todbot/picotouch_pad/README.md

# picotouch_pad
picotouch MIDI controller, but pad-based
