todbot/picotouch_pad/schematics/picotouch_pad/picotouch_pad.kicad_pcb

## KiCad design schematics/picotouch_pad/picotouch_pad.kicad_pcb (2024-12-15)

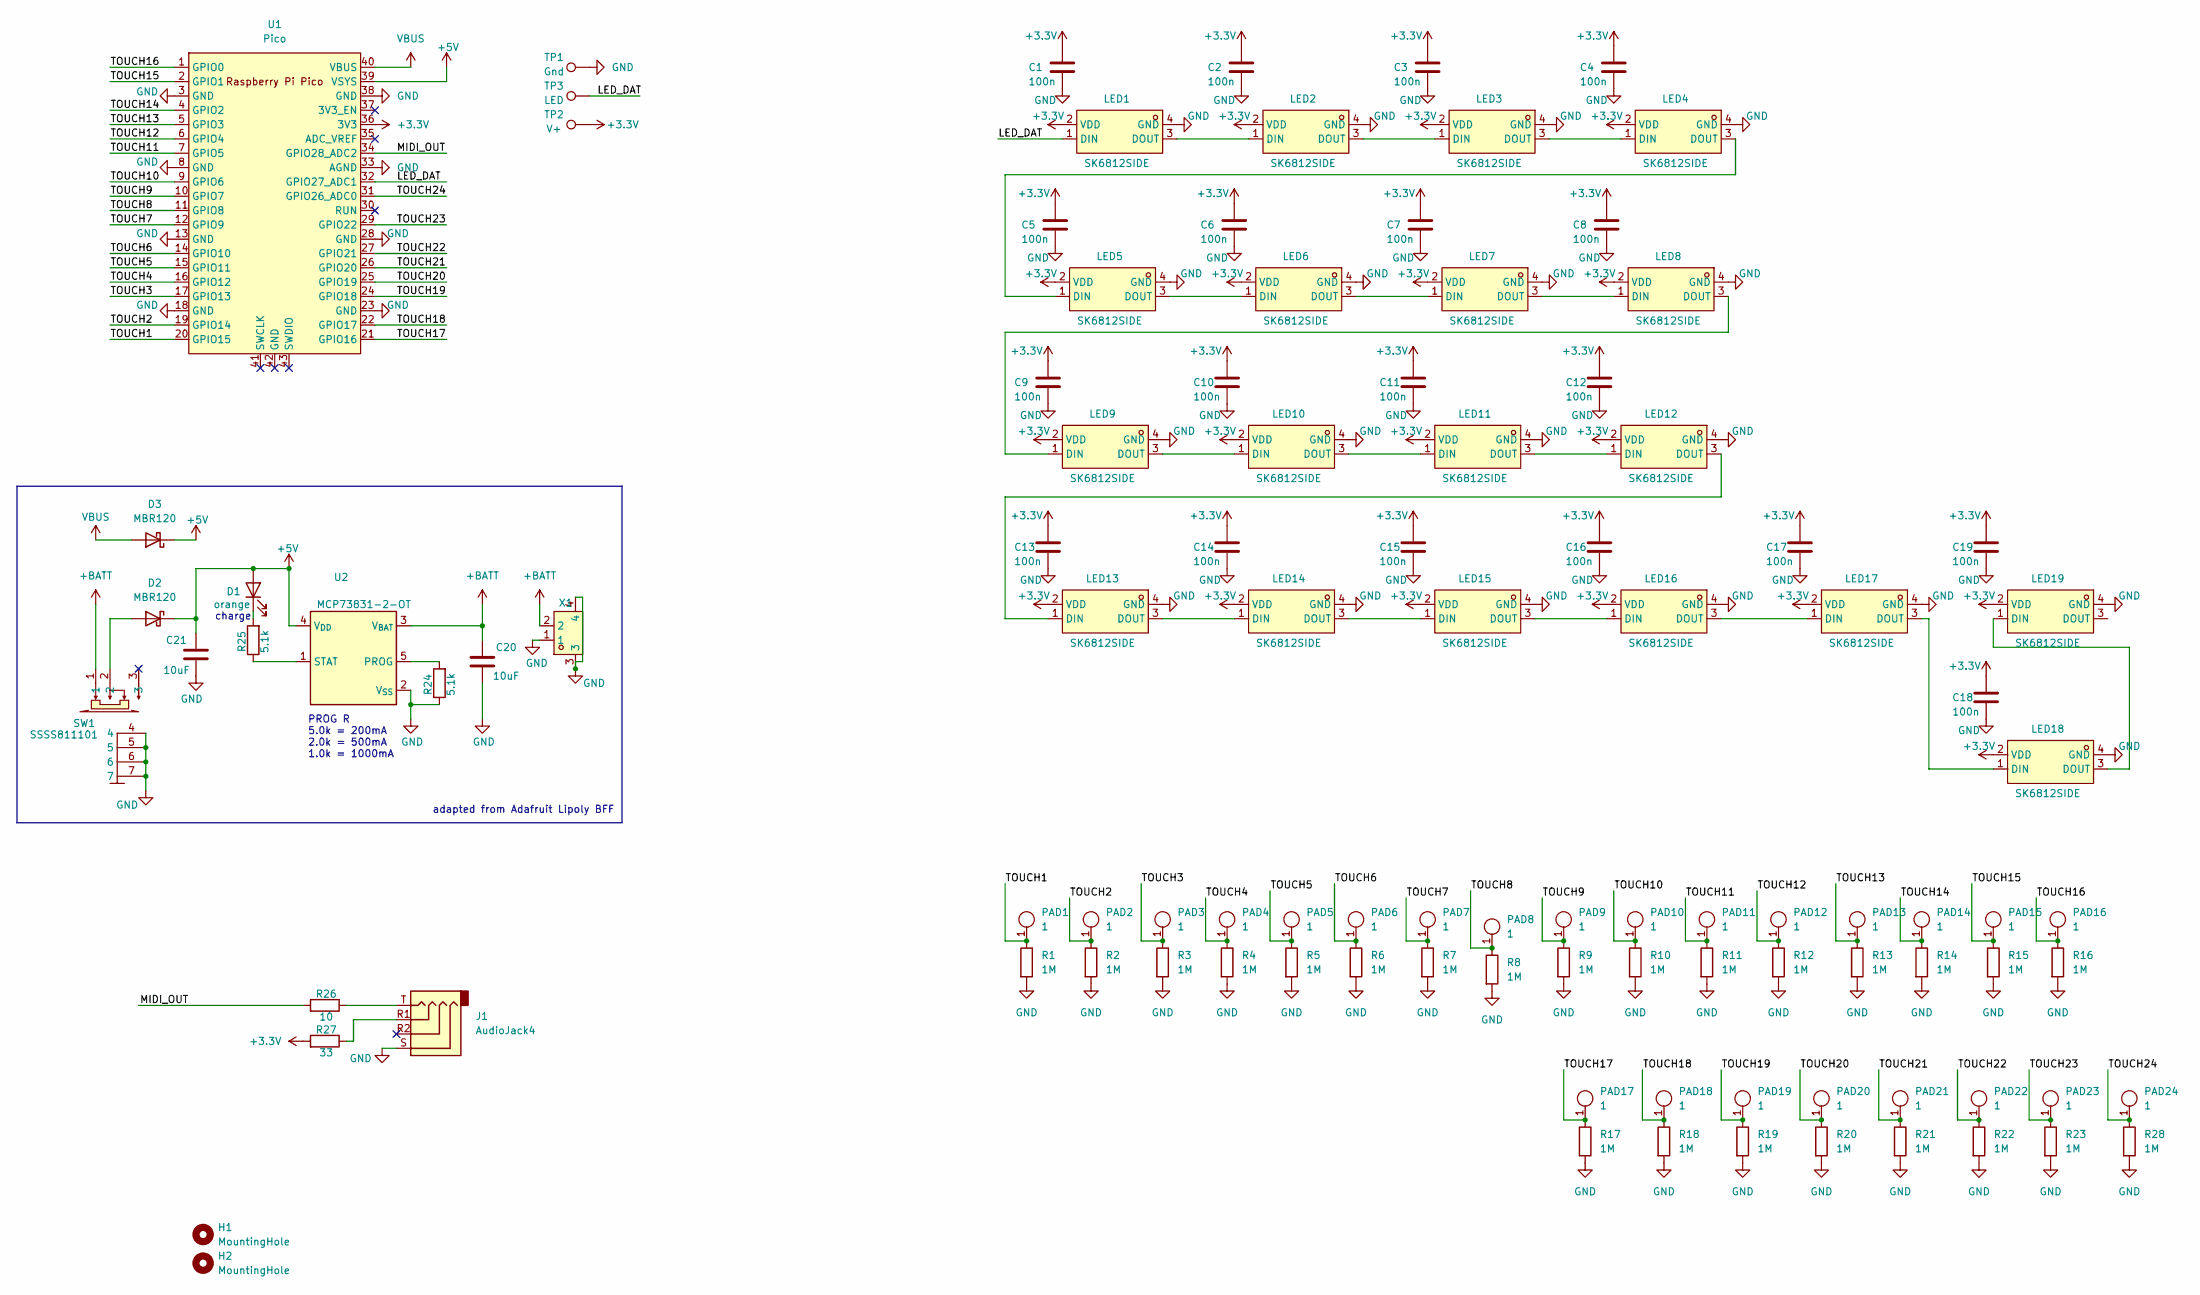
[picture p1: schematic picotouch_pad.kicad_sch]

Parts:
C1, C2, C3, C4, C5, C6, C7, C8, C9, C10, C11, C12, C13, C14, C15, C16, C17, C18, C19: 100n; C_0603_1608Metric
C20, C21: 10uF; C_0603_1608Metric
D1: orange; LED_0603_1608Metric
D2, D3: MBR120; D_SOD-123F; LCSC Part C130880
H1, H2: MountingHole; MountingHole_2.7mm_M2.5
J1: AudioJack4; Jack_3.5mm_PJ320D_Horizontal; LCSC C431535
LED1, LED2, LED3, LED4, LED5, LED6, LED7, LED8, LED9, LED10, LED11, LED12, LED13, LED14, LED15, LED16, LED17, LED18, LED19: SK6812SIDE; LED-SMD_4P-L4.0-W1.6-L-keepoutrev; LCSC Part C5378721
PAD1, PAD2, PAD3, PAD4, PAD5, PAD6, PAD7, PAD8, PAD9, PAD10, PAD11, PAD12, PAD13, PAD14, PAD15, PAD16: 1; Pad-CapTouch-10mm-roundrect
PAD17, PAD18, PAD19, PAD20, PAD21, PAD22, PAD23, PAD24: 1; Pad-CapTouch-10x5mm-roundrect
R1, R2, R3, R4, R5, R6, R7, R8, R9, R10, R11, R12, R13, R14, R15, R16, R17, R18, R19, R20, R21, R22, R23, R28: 1M; R_0603_1608Metric
R24, R25: 5.1k; R_0603_1608Metric
R26: 10; R_0603_1608Metric
R27: 33; R_0603_1608Metric
SW1: SSSS811101; SW-SMD_SSSS811101; LCSC Part C109335
TP1: Gnd; TestPoint_Pad_D1.5mm
TP2: V+; TestPoint_Pad_D1.5mm
TP3: LED; TestPoint_Pad_D1.5mm
U1: Pico; RPi_Pico_SMD
U2: MCP73831-2-OT; SOT-23-5; LCSC Part C424093
X1: AFC20-S02ACA-00; CONN-SMD_AFC20-S02ACA-00; LCSC Part C2764211

Connections:
+3.3V: C1.1, C2.1, C3.1, C4.1, C5.1, C6.1, C7.1, C8.1, C9.1, C10.1, C11.1, C12.1, C13.1, C14.1, C15.1, C16.1, C17.1, C18.1, C19.1, LED1.2 (VDD), LED2.2 (VDD), LED3.2 (VDD), LED4.2 (VDD), LED5.2 (VDD), LED6.2 (VDD), LED7.2 (VDD), LED8.2 (VDD), LED9.2 (VDD), LED10.2 (VDD), LED11.2 (VDD), LED12.2 (VDD), LED13.2 (VDD), LED14.2 (VDD), LED15.2 (VDD), LED16.2 (VDD), LED17.2 (VDD), LED18.2 (VDD), LED19.2 (VDD), R27.2, TP2.1, U1.36 (3V3)
+5V: C21.1, D1.2 (A), D2.1 (K), D3.1 (K), U1.39 (VSYS), U2.4 (V_{DD})
+BATT: C20.1, SW1.1, U2.3 (V_{BAT}), X1.2
/LED_DAT: LED1.1 (DIN), TP3.1, U1.32 (GPIO27_ADC1)
/MIDI_OUT: R26.2, U1.34 (GPIO28_ADC2)
/TOUCH1: PAD1.1 (A), R1.1, U1.20 (GPIO15)
/TOUCH2: PAD2.1 (A), R2.1, U1.19 (GPIO14)
/TOUCH3: PAD3.1 (A), R3.1, U1.17 (GPIO13)
/TOUCH4: PAD4.1 (A), R4.1, U1.16 (GPIO12)
/TOUCH5: PAD5.1 (A), R5.1, U1.15 (GPIO11)
/TOUCH6: PAD6.1 (A), R6.1, U1.14 (GPIO10)
/TOUCH7: PAD7.1 (A), R7.1, U1.12 (GPIO9)
/TOUCH8: PAD8.1 (A), R8.1, U1.11 (GPIO8)
/TOUCH9: PAD9.1 (A), R9.1, U1.10 (GPIO7)
/TOUCH10: PAD10.1 (A), R10.1, U1.9 (GPIO6)
/TOUCH11: PAD11.1 (A), R11.1, U1.7 (GPIO5)
/TOUCH12: PAD12.1 (A), R12.1, U1.6 (GPIO4)
/TOUCH13: PAD13.1 (A), R13.1, U1.5 (GPIO3)
/TOUCH14: PAD14.1 (A), R14.1, U1.4 (GPIO2)
/TOUCH15: PAD15.1 (A), R15.1, U1.2 (GPIO1)
/TOUCH16: PAD16.1 (A), R16.1, U1.1 (GPIO0)
/TOUCH17: PAD17.1 (A), R17.1, U1.21 (GPIO16)
/TOUCH18: PAD18.1 (A), R18.1, U1.22 (GPIO17)
/TOUCH19: PAD19.1 (A), R19.1, U1.24 (GPIO18)
/TOUCH20: PAD20.1 (A), R20.1, U1.25 (GPIO19)
/TOUCH21: PAD21.1 (A), R21.1, U1.26 (GPIO20)
/TOUCH22: PAD22.1 (A), R22.1, U1.27 (GPIO21)
/TOUCH23: PAD23.1 (A), R23.1, U1.29 (GPIO22)
/TOUCH24: PAD24.1 (A), R28.1, U1.31 (GPIO26_ADC0)
GND: C1.2, C2.2, C3.2, C4.2, C5.2, C6.2, C7.2, C8.2, C9.2, C10.2, C11.2, C12.2, C13.2, C14.2, C15.2, C16.2, C17.2, C18.2, C19.2, C20.2, C21.2, J1.S, LED1.4 (GND), LED2.4 (GND), LED3.4 (GND), LED4.4 (GND), LED5.4 (GND), LED6.4 (GND), LED7.4 (GND), LED8.4 (GND), LED9.4 (GND), LED10.4 (GND), LED11.4 (GND), LED12.4 (GND), LED13.4 (GND), LED14.4 (GND), LED15.4 (GND), LED16.4 (GND), LED17.4 (GND), LED18.4 (GND), LED19.4 (GND), R1.2, R2.2, R3.2, R4.2, R5.2, R6.2, R7.2, R8.2, R9.2, R10.2, R11.2, R12.2, R13.2, R14.2, R15.2, R16.2, R17.2, R18.2, R19.2, R20.2, R21.2, R22.2, R23.2, R24.1, R28.2, SW1.4, SW1.5, SW1.6, SW1.7, TP1.1, U1.3 (GND), U1.8 (GND), U1.13 (GND), U1.18 (GND), U1.23 (GND), U1.28 (GND), U1.33 (AGND), U1.38 (GND), U2.2 (V_{SS}), X1.1, X1.3, X1.4
unnamed: D1.1 (K), R25.2
unnamed: D2.2 (A), SW1.2
unnamed: J1.R1, R27.1
unnamed: J1.T, R26.1
unnamed: LED1.3 (DOUT), LED2.1 (DIN)
unnamed: LED2.3 (DOUT), LED3.1 (DIN)
unnamed: LED3.3 (DOUT), LED4.1 (DIN)
unnamed: LED4.3 (DOUT), LED5.1 (DIN)
unnamed: LED5.3 (DOUT), LED6.1 (DIN)
unnamed: LED6.3 (DOUT), LED7.1 (DIN)
unnamed: LED7.3 (DOUT), LED8.1 (DIN)
unnamed: LED8.3 (DOUT), LED9.1 (DIN)
unnamed: LED9.3 (DOUT), LED10.1 (DIN)
unnamed: LED10.3 (DOUT), LED11.1 (DIN)
unnamed: LED11.3 (DOUT), LED12.1 (DIN)
unnamed: LED12.3 (DOUT), LED13.1 (DIN)
unnamed: LED13.3 (DOUT), LED14.1 (DIN)
unnamed: LED14.3 (DOUT), LED15.1 (DIN)
unnamed: LED15.3 (DOUT), LED16.1 (DIN)
unnamed: LED16.3 (DOUT), LED17.1 (DIN)
unnamed: LED17.3 (DOUT), LED18.1 (DIN)
unnamed: LED18.3 (DOUT), LED19.1 (DIN)
unnamed: R24.2, U2.5 (PROG)
unnamed: R25.1, U2.1 (STAT)
VBUS: D3.2 (A), U1.40 (VBUS)

Notes on the sheet:
PROG R 5.0k = 200mA 2.0k = 500mA 1.0k = 1000mA
adapted from Adafruit Lipoly BFF
charge

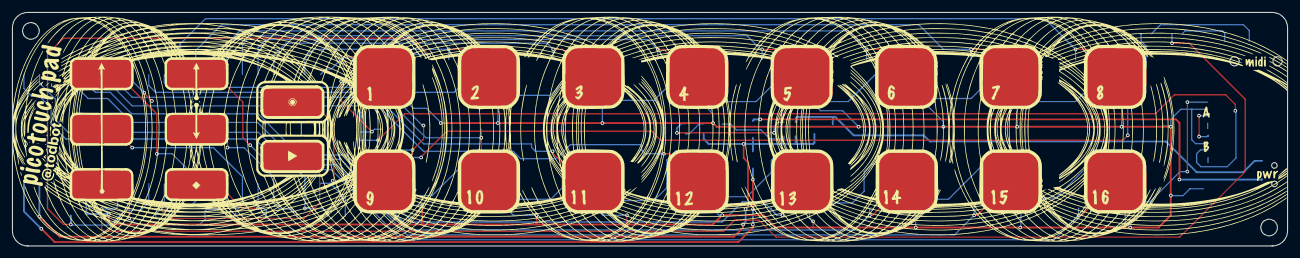
[picture p2: board picotouch_pad.kicad_pcb from above]

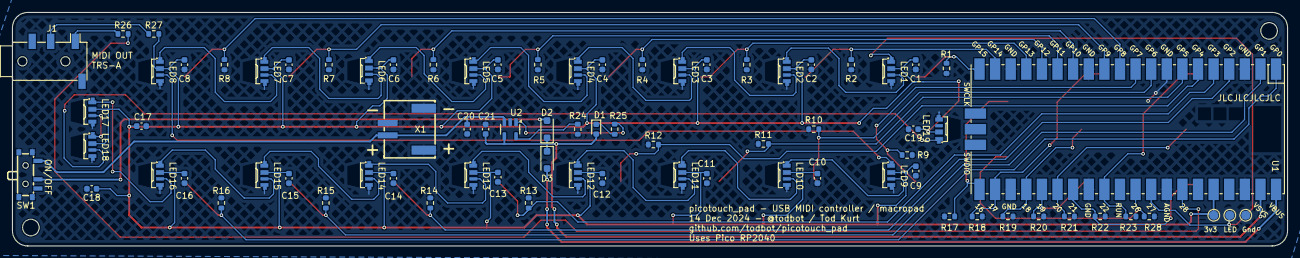
[picture p3: board picotouch_pad.kicad_pcb from below]

Board: 2 copper layers, 207.5 x 38.0 mm, 105 parts (79 on the bottom side), 55 nets.
