todbot/picotouch_pad/schematics/picotouch_pad_proto/picotouch_pad_proto.kicad_pcb

## KiCad design schematics/picotouch_pad_proto/picotouch_pad_proto.kicad_pcb (2024-09-06)

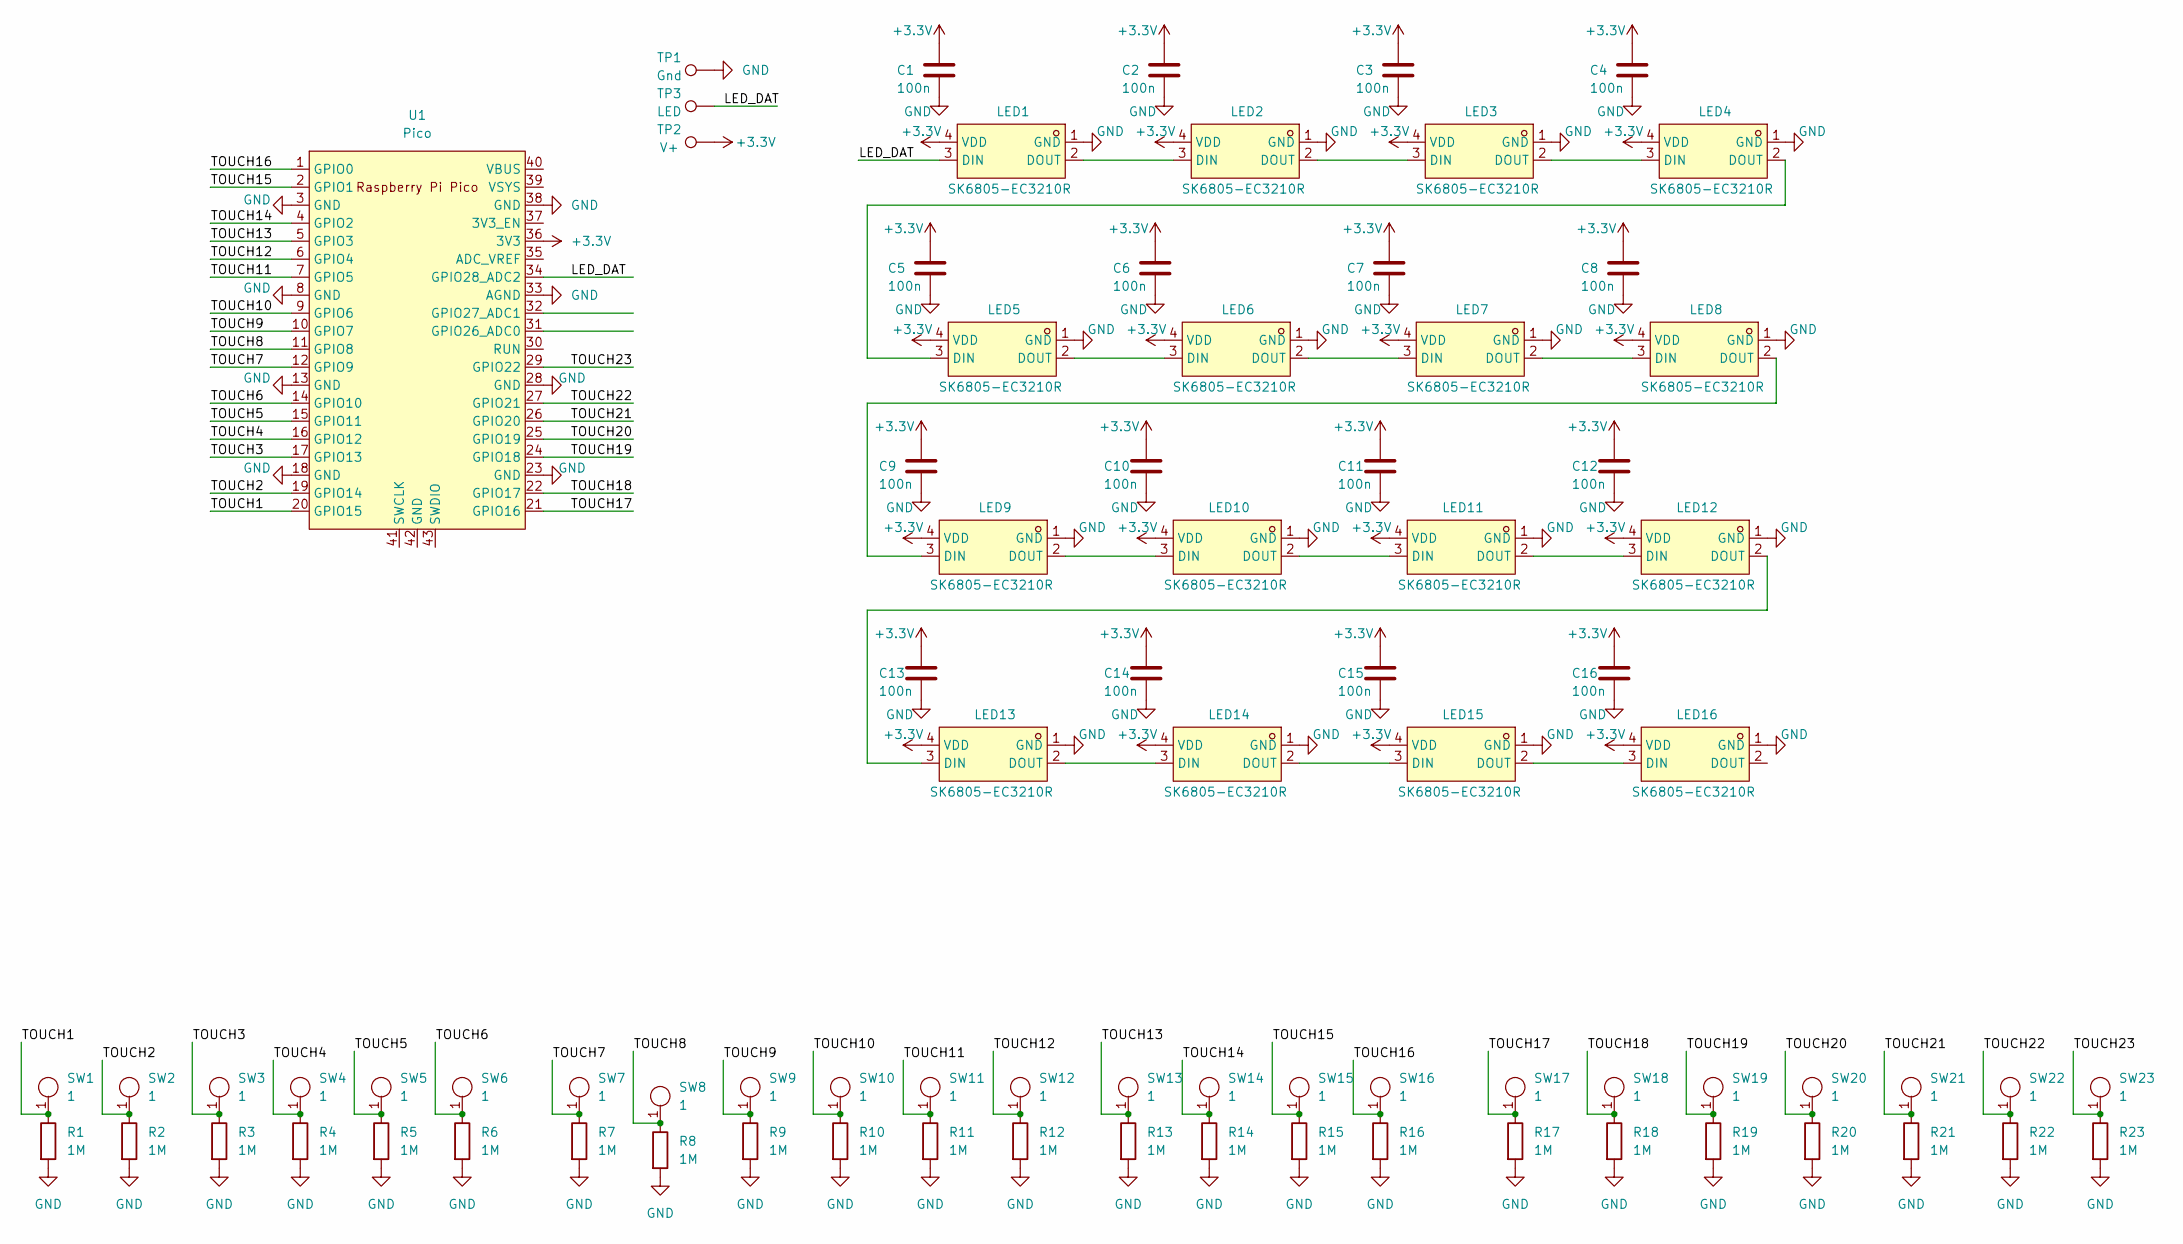
[picture p4: schematic picotouch_pad_proto.kicad_sch]

Parts:
C1, C2, C3, C4, C5, C6, C7, C8, C9, C10, C11, C12, C13, C14, C15, C16: 100n; C_0603_1608Metric
LED1, LED2, LED3, LED4, LED5, LED6, LED7, LED8, LED9, LED10, LED11, LED12, LED13, LED14, LED15, LED16: SK6805-EC3210R; LED-SMD_4P-L3.2-W1.5_SK6805-EC3210R-keepout; LCSC Part C5378735
R1, R2, R3, R4, R5, R6, R7, R8, R9, R10, R11, R12, R13, R14, R15, R16, R17, R18, R19, R20, R21, R22, R23: 1M; R_0603_1608Metric
SW1, SW2, SW3, SW4, SW5, SW6, SW7, SW8, SW9, SW10, SW11, SW12, SW13, SW14, SW15, SW16: 1; Pad-CapTouch-10mm-roundrect
SW17, SW18, SW19, SW20, SW21, SW22, SW23: 1; Pad-CapTouch-10x5mm-roundrect
TP1: Gnd; TestPoint_Pad_D1.5mm
TP2: V+; TestPoint_Pad_D1.5mm
TP3: LED; TestPoint_Pad_D1.5mm
U1: Pico; RPi_Pico_SMD

Connections:
+3.3V: C1.1, C2.1, C3.1, C4.1, C5.1, C6.1, C7.1, C8.1, C9.1, C10.1, C11.1, C12.1, C13.1, C14.1, C15.1, C16.1, LED1.4 (VDD), LED2.4 (VDD), LED3.4 (VDD), LED4.4 (VDD), LED5.4 (VDD), LED6.4 (VDD), LED7.4 (VDD), LED8.4 (VDD), LED9.4 (VDD), LED10.4 (VDD), LED11.4 (VDD), LED12.4 (VDD), LED13.4 (VDD), LED14.4 (VDD), LED15.4 (VDD), LED16.4 (VDD), TP2.1, U1.36 (3V3)
/LED_DAT: LED1.3 (DIN), TP3.1, U1.34 (GPIO28_ADC2)
/TOUCH1: R1.1, SW1.1 (A), U1.20 (GPIO15)
/TOUCH2: R2.1, SW2.1 (A), U1.19 (GPIO14)
/TOUCH3: R3.1, SW3.1 (A), U1.17 (GPIO13)
/TOUCH4: R4.1, SW4.1 (A), U1.16 (GPIO12)
/TOUCH5: R5.1, SW5.1 (A), U1.15 (GPIO11)
/TOUCH6: R6.1, SW6.1 (A), U1.14 (GPIO10)
/TOUCH7: R7.1, SW7.1 (A), U1.12 (GPIO9)
/TOUCH8: R8.1, SW8.1 (A), U1.11 (GPIO8)
/TOUCH9: R9.1, SW9.1 (A), U1.10 (GPIO7)
/TOUCH10: R10.1, SW10.1 (A), U1.9 (GPIO6)
/TOUCH11: R11.1, SW11.1 (A), U1.7 (GPIO5)
/TOUCH12: R12.1, SW12.1 (A), U1.6 (GPIO4)
/TOUCH13: R13.1, SW13.1 (A), U1.5 (GPIO3)
/TOUCH14: R14.1, SW14.1 (A), U1.4 (GPIO2)
/TOUCH15: R15.1, SW15.1 (A), U1.2 (GPIO1)
/TOUCH16: R16.1, SW16.1 (A), U1.1 (GPIO0)
/TOUCH17: R17.1, SW17.1 (A), U1.21 (GPIO16)
/TOUCH18: R18.1, SW18.1 (A), U1.22 (GPIO17)
/TOUCH19: R19.1, SW19.1 (A), U1.24 (GPIO18)
/TOUCH20: R20.1, SW20.1 (A), U1.25 (GPIO19)
/TOUCH21: R21.1, SW21.1 (A), U1.26 (GPIO20)
/TOUCH22: R22.1, SW22.1 (A), U1.27 (GPIO21)
/TOUCH23: R23.1, SW23.1 (A), U1.29 (GPIO22)
GND: C1.2, C2.2, C3.2, C4.2, C5.2, C6.2, C7.2, C8.2, C9.2, C10.2, C11.2, C12.2, C13.2, C14.2, C15.2, C16.2, LED1.1 (GND), LED2.1 (GND), LED3.1 (GND), LED4.1 (GND), LED5.1 (GND), LED6.1 (GND), LED7.1 (GND), LED8.1 (GND), LED9.1 (GND), LED10.1 (GND), LED11.1 (GND), LED12.1 (GND), LED13.1 (GND), LED14.1 (GND), LED15.1 (GND), LED16.1 (GND), R1.2, R2.2, R3.2, R4.2, R5.2, R6.2, R7.2, R8.2, R9.2, R10.2, R11.2, R12.2, R13.2, R14.2, R15.2, R16.2, R17.2, R18.2, R19.2, R20.2, R21.2, R22.2, R23.2, TP1.1, U1.3 (GND), U1.8 (GND), U1.13 (GND), U1.18 (GND), U1.23 (GND), U1.28 (GND), U1.33 (AGND), U1.38 (GND)
unnamed: LED1.2 (DOUT), LED2.3 (DIN)
unnamed: LED2.2 (DOUT), LED3.3 (DIN)
unnamed: LED3.2 (DOUT), LED4.3 (DIN)
unnamed: LED4.2 (DOUT), LED5.3 (DIN)
unnamed: LED5.2 (DOUT), LED6.3 (DIN)
unnamed: LED6.2 (DOUT), LED7.3 (DIN)
unnamed: LED7.2 (DOUT), LED8.3 (DIN)
unnamed: LED8.2 (DOUT), LED9.3 (DIN)
unnamed: LED9.2 (DOUT), LED10.3 (DIN)
unnamed: LED10.2 (DOUT), LED11.3 (DIN)
unnamed: LED11.2 (DOUT), LED12.3 (DIN)
unnamed: LED12.2 (DOUT), LED13.3 (DIN)
unnamed: LED13.2 (DOUT), LED14.3 (DIN)
unnamed: LED14.2 (DOUT), LED15.3 (DIN)
unnamed: LED15.2 (DOUT), LED16.3 (DIN)

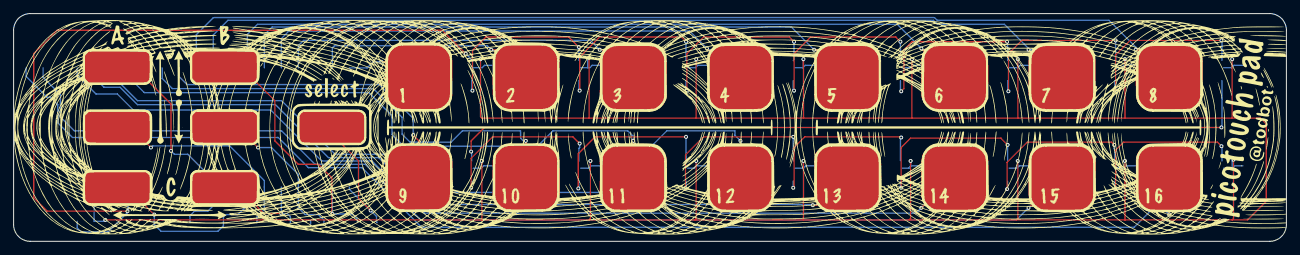
[picture p5: board picotouch_pad_proto.kicad_pcb from above]

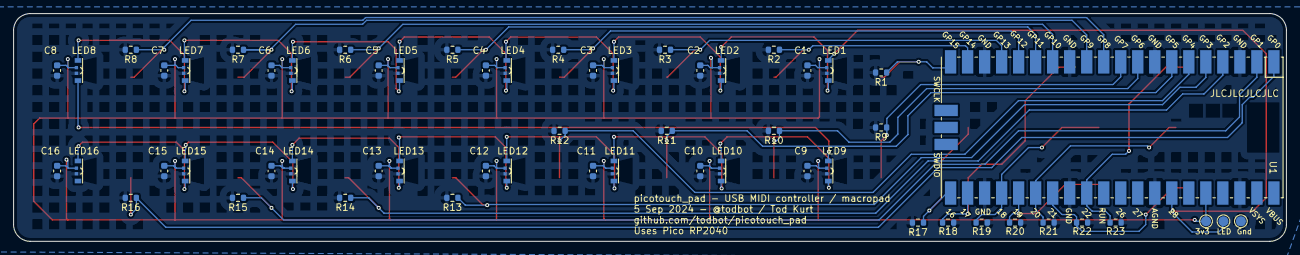
[picture p6: board picotouch_pad_proto.kicad_pcb from below]

Board: 2 copper layers, 190.0 x 34.0 mm, 82 parts (59 on the bottom side), 41 nets.
