todbot/picotouch_pad/(commit log)

2024-09-06 files as sent to fab
    [picotouch_pad.kicad_pcb]
2024-09-12 new pcb with sk6812side
    [picotouch_pad.kicad_pcb, picotouch_pad.kicad_sch]
2024-09-16 add battery circuit
    [picotouch_pad.kicad_pcb, picotouch_pad.kicad_sch]
2024-09-16 add midi out
    [picotouch_pad.kicad_pcb, picotouch_pad.kicad_sch]
2024-09-20 new silkscreen and fixes
    [picotouch_pad.kicad_pcb, picotouch_pad.kicad_sch]
2024-09-20 add picotouch_pad_proto pcb
    [picotouch_pad_proto.kicad_pcb, picotouch_pad_proto.kicad_sch]
2024-09-21 octave & mod wheel buttons work on picotouch_pad_proto
2024-09-23 resize, cleanup, change battery charge chip sch symbol
    [picotouch_pad.kicad_pcb, picotouch_pad.kicad_sch]
2024-09-30 picotouch_pad_proto: add modwheel ramping
    [picotouch_pad.kicad_pcb]
2024-10-10 add vbus diode, fix up power layout a bit
    [picotouch_pad.kicad_pcb, picotouch_pad.kicad_sch]
2024-11-16 cleanup and new silkscreen
    [picotouch_pad.kicad_pcb, picotouch_pad.kicad_sch]
2024-11-16 more layout tuning
    [picotouch_pad.kicad_pcb]
2024-12-15 one net forgot! fix +5V to VSYS
    [picotouch_pad.kicad_pcb, picotouch_pad.kicad_sch]
